remigius42/wb3s-jig/(commit log)

2026-06-14 feat: add WB3S programming jig and guides
    Introduce the project's deliverable and its documentation:
    - wb3s_jig.scad — the OpenSCAD clip-on cap + sprung clamp that lands
    five Dupont pins on a soldered WB3S's edge pads for UART flashing.
    - README.md — pinout, hardware chain, flashing workflow, and print/
    render notes; flagged work-in-progress as nothing its
    hardware-verified.
    - tuya-ir.md / tuya-ir-rf.md — device flashing guides (IR, plus the RF
    extension) for the remotes this jig targets.
    - AGENTS.md, CLAUDE.md, and the MIT LICENSE.
    [wb3s_jig.scad]
2026-06-14 docs: clarify flashing-tool install & Linux paths
    ltchiptool was referenced throughout but never named as a
    prerequisite or given an install step; add a pipx/pip line so the
    tooling isn't assumed to be present.
    Correct the GUI-alternative note: BK7231Flasher.exe lives in the
    BK7231GUIFlashTool repo (same project, not a newer tool) and is a
    .NET Framework app that needs Mono on Linux and is unreliable there.
    Steer Linux users to ltchiptool (manual image download) with
    hid_download_py as a no-Mono CLI fallback, so non-Windows users
    aren't pushed toward a painful path.
2026-06-16 feat: wedge pin walls, fix pad geometry & labels
    Refines the jig after first fit/flash testing.
    Geometry — taper the two long (pin-bearing) walls into an X-Z
    trapezoid (wall_base 1mm at the bench -> wall_top 5mm at the
    roof). The thin base shrinks the footprint where it fouls
    neighbouring parts on a cramped host PCB, while the extra material
    up top lengthens the bore that grips each Dupont pin. Inner
    registration faces stay vertical (set by the cavity cuts), and the
    flare is an underhang when the cap prints roof-down.
    Pad accuracy — derive all pad Y-positions from pad_y0/pad_pitch
    taken from the MODULE drawing (Fig 6-1, 1.5485mm corner offset)
    instead of the host land pattern (Fig 6-3,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
    [wb3s_jig.scad]
2026-06-21 feat: spring-loaded parallelogram contacts
    Replace the rigid Dupont pins pushed into angled channels (which loaded
    the vertical castellation nearly orthogonally) with SPRUNG contacts:
    each male pin sits in a vertical sleeve carried on a two-arm
    parallelogram flexure, pressing DOWN on the exposed solder toe just
    outboard of the module edge so the clamp/spring force loads the contact
    directly. The clamp now supplies the preload, so it must resist the sum
    of the five arm reactions. This makes the jig host-specific - it relies
    on an exposed toe outboard of the edge.
    The parallelogram translates the pin straight down without rotating, so
    it self-seats and does not walk off the narrow toe under l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
    [wb3s_jig.scad]
2026-06-23 fix: harden central block & deboss legibility
    The central strip between the L/R pockets carries the top-arm anchors
    and the T/R labels, and its width shrinks as arm_len grows with
    layer_h. Cap layer_h at 0.16mm and assert the strip stays solid so a
    coarser layer can't silently starve the core or shave the labels.
    Recenter T/R into that strip (T over R, margin split both sides) so a
    thinner strip degrades gracefully; drop the now-unused pair-pocket
    band geometry. Tighten relief_clear 0.5 -> 0.35mm to widen the strip.
    Break pad_relief cleanly through the short edge when less than a wall_t
    would remain, avoiding an unprintable sliver. Grow antenna trace lines
    by 2x0.1mm so the debossed groove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
    [wb3s_jig.scad]
2026-06-23 chore: gitignore firmware images
    Keep .bin firmware out of the repo: they are binary blobs and a stock
    dump contains the device Wi-Fi SSID/password, so they must not be
    committed.
2026-06-23 docs: recommend UA release image over GUI flasher
    The README and IR guide leaned on BK7231Flasher to fetch the firmware,
    but it's a .NET app that needs Mono on Linux and is flaky there. Point
    Linux users straight at ltchiptool with the prebuilt OpenBeken release
    image instead.
    Name the specific asset: the OpenBK7231T_UA ("UART flash") image is
    app-only and flashed at 0x11000, so it can't overwrite the bootloader
    and brick the BK7231T — and steer away from the QIO image, which spans
    the bootloader needlessly. Demote the GUI tool to a Windows-only
    note.
2026-06-23 docs: flesh out IR config in OpenBeken/ESPHome guide
    Point pin-finding at the CS-SSRC-IRC OpenBeken config as the shared
    baseline for both Tuya WB3S remotes, listing the common IR pins and
    noting P23 dInput is the IR+RF unit's side button (absent on IR-only).
    Extend the ESPHome example with the LED and a template-button send
    example, and explain the IR-code tradeoff: hard-coded decoded
    protocols regenerate a clean waveform, while the runtime options
    (globals slots, IR/RF Proxy) replay raw timings and are more fragile —
    their only win being learning unknown remotes without a re-flash.
2026-06-23 docs: sync README with sprung-arm design
    The README still described the old rigid-bore PLA jig; bring it in line
    with the parallelogram-flexure design in wb3s_jig.scad.
    Rewrite the intro and Contacts/Clamp notes around the sprung sleeves
    pressing the solder toe, and reverse the print guidance: PETG (not PLA,
    which would snap the flex arms), layer height <=0.16mm so each arm is
    >=2 layers, a well-dialed-in printer for the tight clearances, and the
    corrected flipped print orientation.
    Quote the real figures from the .scad: ~0.4mm preload, ~1.6N/pin, and a
    0.2mm clamp press resisting the ~8N sum of arm reactions. Drop the
    "untested" warning now that the design has flashed real hardware.
2026-06-23 docs: explain TXD1/RXD1 cross and UART1
    Clarify that TXD1/RXD1 are the module's own UART1 pins (named from the
    chip's side), which is why they cross to the adapter — module TX to
    adapter RX and vice versa. Also warn to use UART1, since TXD2/RXD2
    carries only the Tuya boot log, not the programming port.
