remigius42/wb3s-jig/(notices)

Notices in the files:
README.md:
License: MIT
